Alignof/SeccampConnect2026/README.md

# SeccampConnect2026
  Security Camp Connect 2026
