Alignof/SeccampConnect2026/(list of files, drawings)

Other design files:
Fritzing/keyboard.fzz
