Alignof/SeccampConnect2026/Kicad/board.kicad_pcb

## KiCad design Kicad/board.kicad_pcb (2026-03-22)

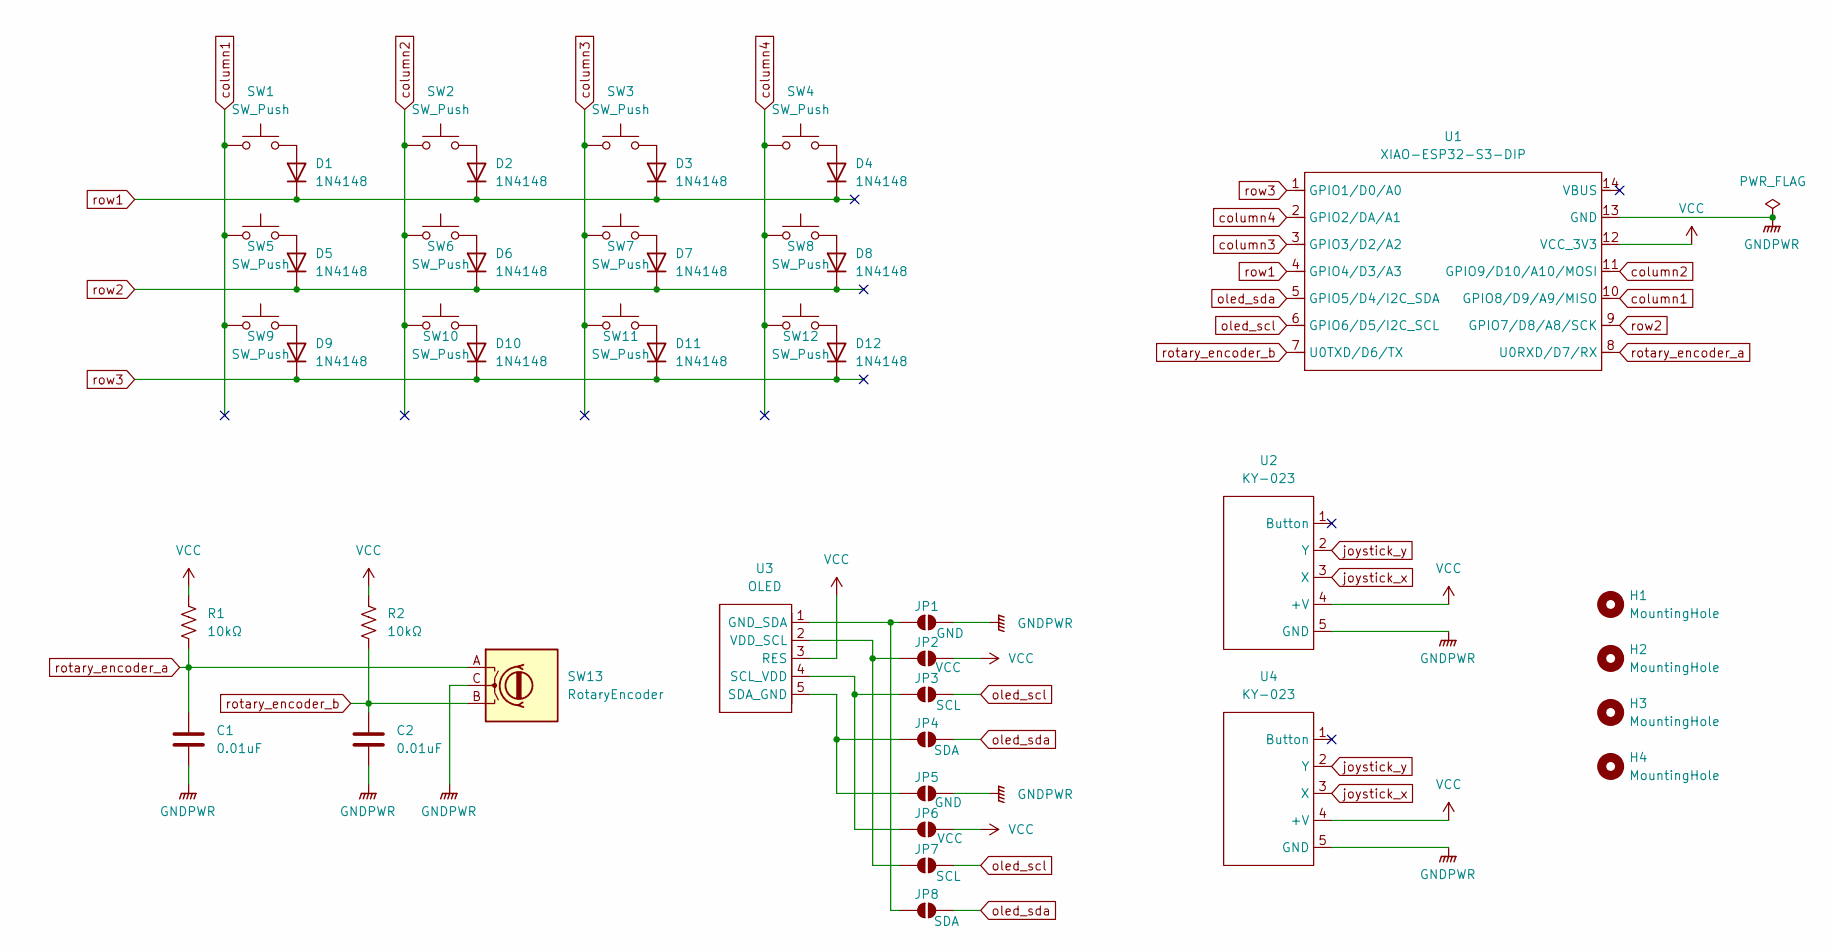
[picture p1: schematic board.kicad_sch]

Parts:
C1, C2: 0.01uF; C_0805_2012_HandSolder_reversible
D1, D2, D3, D4, D5, D6, D7, D8, D9, D10, D11, D12: 1N4148; Diode_THT_reversible
H1, H2, H3, H4: MountingHole; MountingHole_2.7mm
JP1, JP5: GND; SolderJumper-2_P1.3mm_Open_TrianglePad1.0x1.5mm
JP2, JP6: VCC; SolderJumper-2_P1.3mm_Open_TrianglePad1.0x1.5mm
JP3, JP7: SCL; SolderJumper-2_P1.3mm_Open_TrianglePad1.0x1.5mm
JP4, JP8: SDA; SolderJumper-2_P1.3mm_Open_TrianglePad1.0x1.5mm
R1, R2: 10kΩ; R_L6.3mm_D2.5mm_P10.16mm_Horizontal_reversible
SW1, SW2, SW3, SW4, SW5, SW6, SW7, SW8, SW9, SW10, SW11, SW12: SW_Push; Kailh_socket_PG1350_optional_reversible
SW13: RotaryEncoder; RotaryEncoder_Alps_EC12E_Vertical_H20mm
U1: XIAO-ESP32-S3-DIP; XIAO-ESP32S3_reversible
U2, U4: KY-023
U3: OLED; PinSocket_1x05_P2.54mm_Vertical

Connections:
GNDPWR: C1.2, C2.2, JP1.2 (B), JP5.2 (B), SW13.C, U1.13 (GND), U2.5 (GND), U4.5 (GND)
unnamed: D1.2 (A), SW1.2
unnamed: D2.2 (A), SW2.2
unnamed: D3.2 (A), SW3.2
unnamed: D4.2 (A), SW4.2
unnamed: D5.2 (A), SW5.2
unnamed: D6.2 (A), SW6.2
unnamed: D7.2 (A), SW7.2
unnamed: D8.2 (A), SW8.2
unnamed: D9.2 (A), SW9.2
unnamed: D10.2 (A), SW10.2
unnamed: D11.2 (A), SW11.2
unnamed: D12.2 (A), SW12.2
unnamed: JP1.1 (A), JP8.1 (A), U3.1 (GND_SDA)
unnamed: JP2.1 (A), JP7.1 (A), U3.2 (VDD_SCL)
unnamed: JP3.1 (A), JP6.1 (A), U3.4 (SCL_VDD)
unnamed: JP4.1 (A), JP5.1 (A), U3.5 (SDA_GND)
unnamed: U2.2 (Y), U4.2 (Y)
unnamed: U2.3 (X), U4.3 (X)
VCC: JP2.2 (B), JP6.2 (B), R1.1, R2.1, U1.12 (VCC_3V3), U2.4 (+V), U3.3 (RES), U4.4 (+V)
column1: SW1.1, SW5.1, SW9.1, U1.10 (GPIO8/D9/A9/MISO)
column2: SW2.1, SW6.1, SW10.1, U1.11 (GPIO9/D10/A10/MOSI)
column3: SW3.1, SW7.1, SW11.1, U1.3 (GPIO3/D2/A2)
column4: SW4.1, SW8.1, SW12.1, U1.2 (GPIO2/DA/A1)
oled_scl: JP3.2 (B), JP7.2 (B), U1.6 (GPIO6/D5/I2C_SCL)
oled_sda: JP4.2 (B), JP8.2 (B), U1.5 (GPIO5/D4/I2C_SDA)
rotary_encoder_a: C1.1, R1.2, SW13.A, U1.8 (U0RXD/D7/RX)
rotary_encoder_b: C2.1, R2.2, SW13.B, U1.7 (U0TXD/D6/TX)
row1: D1.1 (K), D2.1 (K), D3.1 (K), D4.1 (K), U1.4 (GPIO4/D3/A3)
row2: D5.1 (K), D6.1 (K), D7.1 (K), D8.1 (K), U1.9 (GPIO7/D8/A8/SCK)
row3: D9.1 (K), D10.1 (K), D11.1 (K), D12.1 (K), U1.1 (GPIO1/D0/A0)

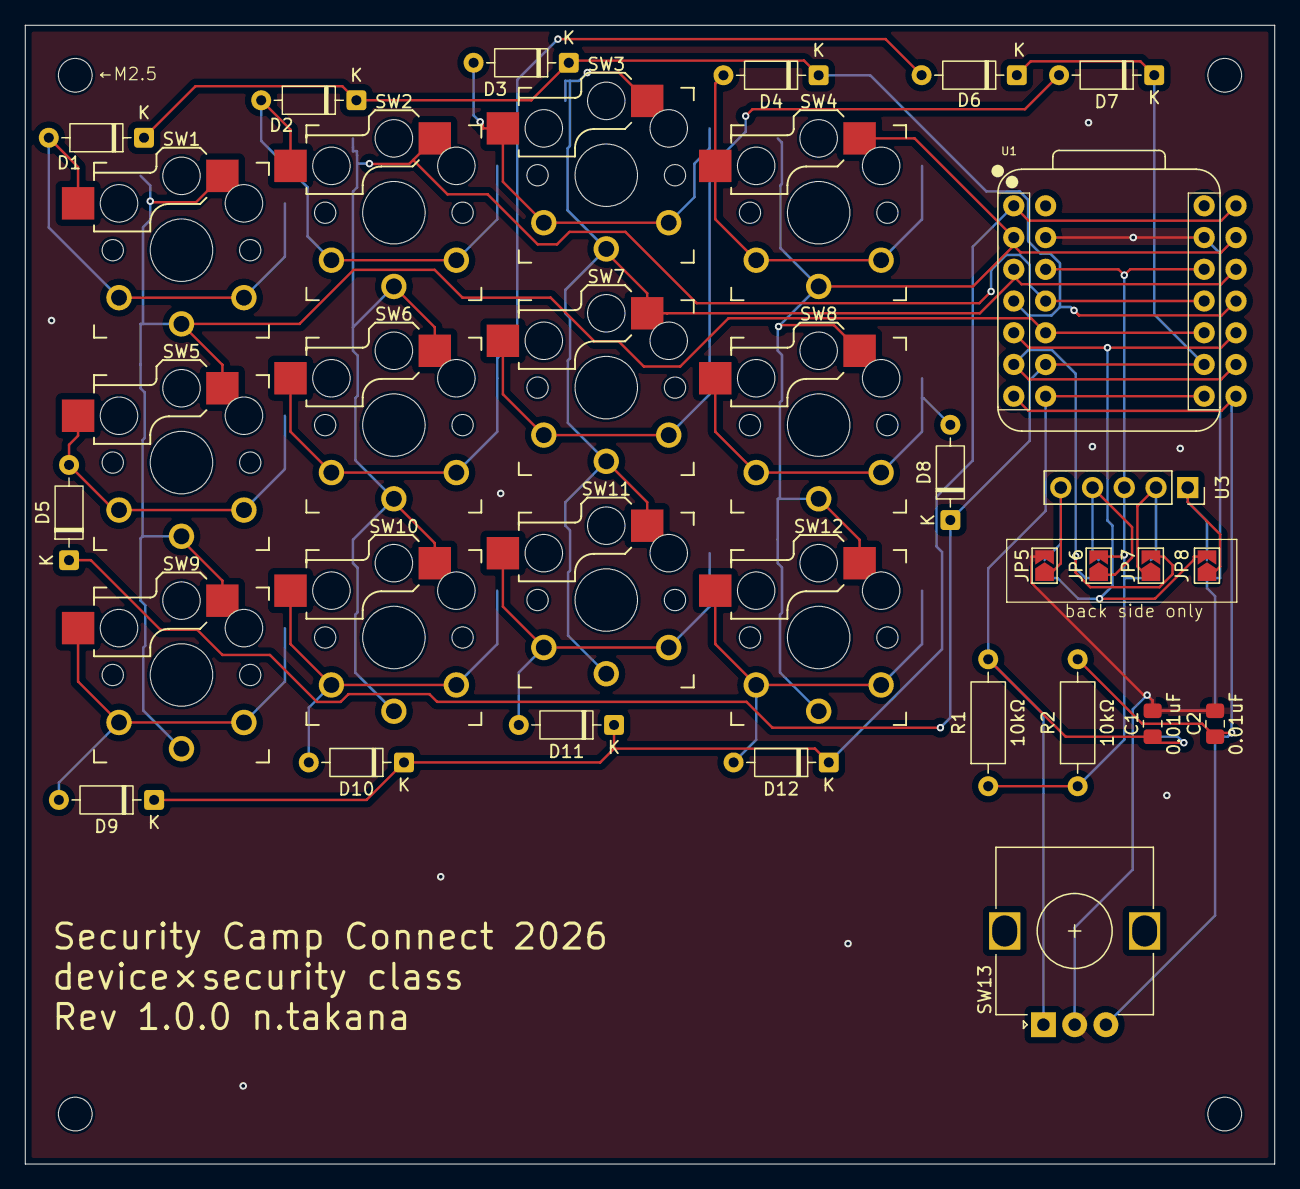
[picture p2: board board.kicad_pcb from above]

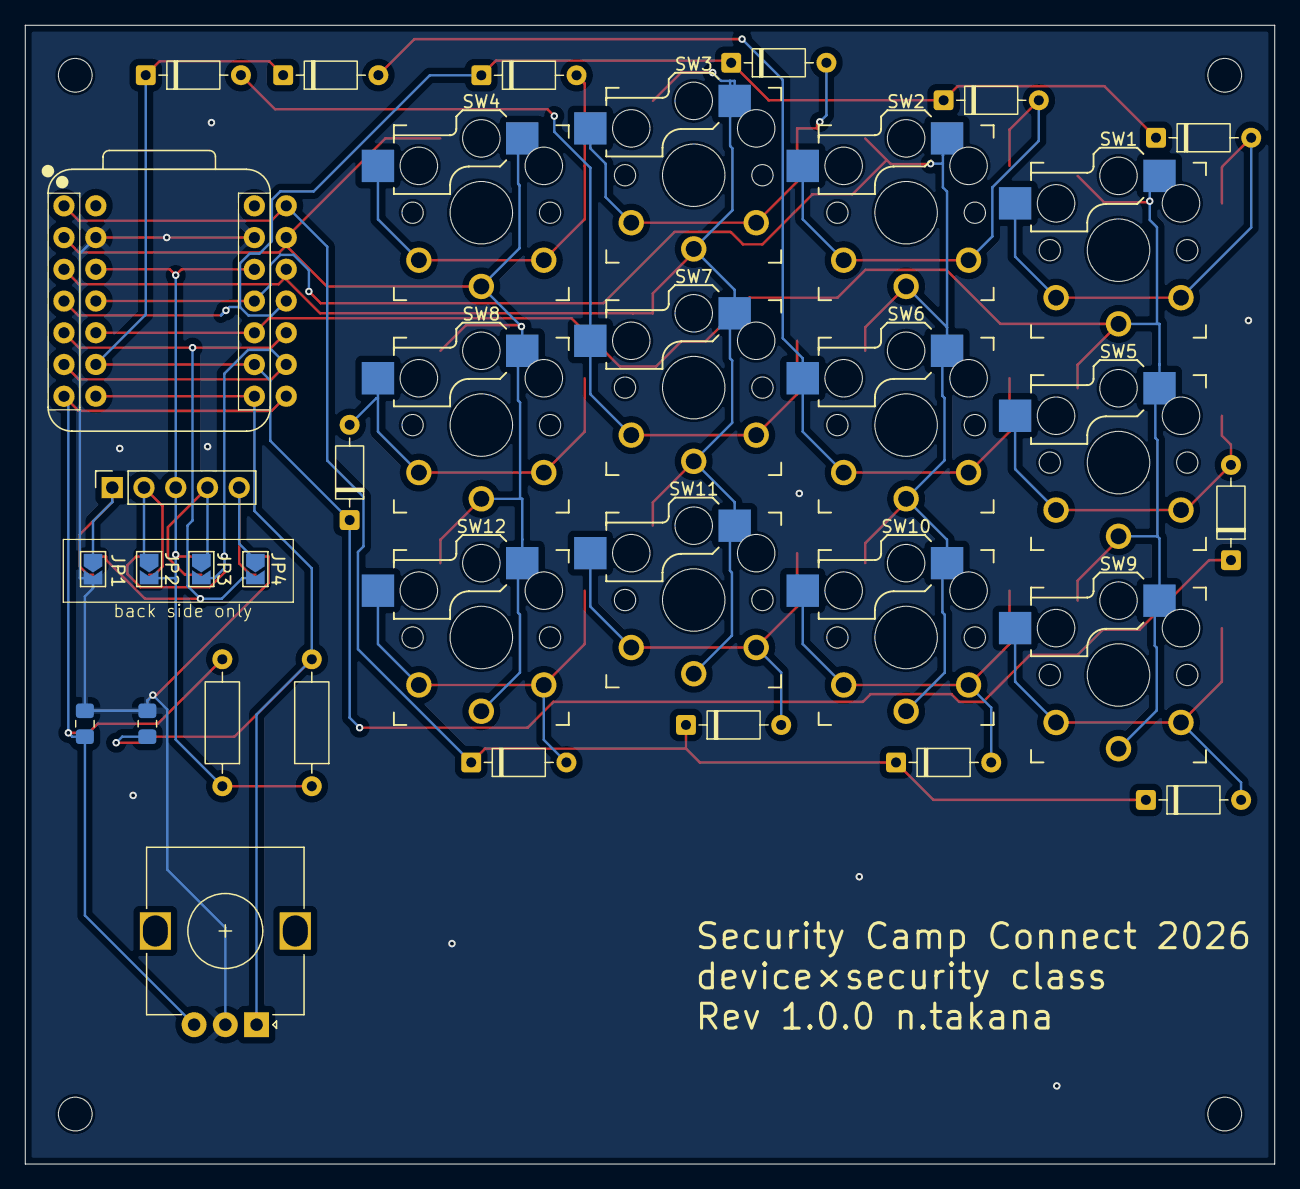
[picture p3: board board.kicad_pcb from below]

Board: 2 copper layers, 100.0 x 91.1 mm, 43 parts (4 on the bottom side), 29 nets.
