Alignof/SeccampConnect2026/src/main.rs

//! Security Camp Connect 2026
//!
//! [https://www.ipa.go.jp/jinzai/security-camp/2025/connect/device.html](https://www.ipa.go.jp/jinzai/security-camp/2025/connect/device.html)
//!
//! 3x4 prototyping keyboards designed for hands-on practice.
//!
//! # Feature
//! - ESP32S3
//! - Vial support
//! - Low profile with 17 mm pitch
//! - Integrated rotary encoder and 0.91-inch OLED

#![no_std]
#![no_main]

mod keymap;
#[macro_use]
mod macros;
mod oled;
mod vial;

use core::ptr::addr_of_mut;

use bt_hci::controller::ExternalController;
use embassy_executor::Spawner;
use esp_hal::clock::CpuClock;
use esp_hal::gpio::{Input, InputConfig, Level, Output, OutputConfig, Pull};
use esp_hal::otg_fs::Usb;
use esp_hal::otg_fs::asynch::{Config, Driver};
use esp_hal::rng::TrngSource;
use esp_hal::timer::timg::TimerGroup;
use esp_radio::Controller;
use esp_radio::ble::controller::BleConnector;
use esp_storage::FlashStorage;
use rmk::ble::build_ble_stack;
use rmk::channel::EVENT_CHANNEL;
use rmk::config::{
    BehaviorConfig, DeviceConfig, PositionalConfig, RmkConfig, StorageConfig, VialConfig,
};
use rmk::debounce::default_debouncer::DefaultDebouncer;
use rmk::futures::future::join3;
use rmk::input_device::Runnable;
use rmk::input_device::rotary_encoder::DefaultPhase;
use rmk::input_device::rotary_encoder::RotaryEncoder;
use rmk::keyboard::Keyboard;
use rmk::matrix::Matrix;
use rmk::storage::async_flash_wrapper;
use rmk::{HostResources, initialize_encoder_keymap_and_storage, run_devices, run_rmk};
use ssd1306::prelude::DisplayRotation;
use static_cell::StaticCell;
use {esp_alloc as _, esp_backtrace as _};

use crate::keymap::{COL, ROW};
use crate::vial::{VIAL_KEYBOARD_DEF, VIAL_KEYBOARD_ID};

::esp_bootloader_esp_idf::esp_app_desc!();

/// Main function.
///
/// Initialize devices and spawn rmk tasks.
#[allow(clippy::used_underscore_binding)]
#[esp_rtos::main]
async fn main(spawner: Spawner) {
    // Singleton for ble controller.
    static RADIO: StaticCell<Controller<'static>> = StaticCell::new();
    // Endpoint buffer for USB transfer.
    static mut EP_MEMORY: [u8; 1024] = [0; 1024];

    // Initialize the peripherals and bluetooth controller
    esp_println::logger::init_logger_from_env();
    let peripherals = esp_hal::init(esp_hal::Config::default().with_cpu_clock(CpuClock::max()));
    esp_alloc::heap_allocator!(size: 72 * 1024);
    let timg0 = TimerGroup::new(peripherals.TIMG0);
    #[cfg(target_arch = "riscv32")]
    let software_interrupt = SoftwareInterruptControl::new(peripherals.SW_INTERRUPT);
    esp_rtos::start(
        timg0.timer0,
        #[cfg(target_arch = "riscv32")]
        software_interrupt.software_interrupt0,
    );
    let _trng_source = TrngSource::new(peripherals.RNG, peripherals.ADC1);
    let mut rng = esp_hal::rng::Trng::try_new().unwrap();
    let radio = RADIO.init(esp_radio::init().unwrap());
    let bluetooth = peripherals.BT;
    let connector = BleConnector::new(radio, bluetooth, esp_radio::ble::Config::default()).unwrap();
    let controller: ExternalController<_, 20> = ExternalController::new(connector);
    let central_addr = [0x18, 0xe2, 0x21, 0x80, 0xc0, 0xc7];
    let mut host_resources = HostResources::new();
    let stack = build_ble_stack(controller, central_addr, &mut rng, &mut host_resources).await;

    // Initialize USB
    let usb = Usb::new(peripherals.USB0, peripherals.GPIO20, peripherals.GPIO19);
    // Create the driver, from the HAL.
    let config = Config::default();
    let usb_driver = Driver::new(usb, unsafe { &mut *addr_of_mut!(EP_MEMORY) }, config);

    // Initialize the flash
    let flash = FlashStorage::new(peripherals.FLASH);
    let flash = async_flash_wrapper(flash);

    // Spawn oled task
    let display = oled::init_oled(
        peripherals.I2C0,
        peripherals.GPIO5,
        peripherals.GPIO6,
        DisplayRotation::Rotate0,
    )
    .await;
    if let Some(display) = display {
        spawner.spawn(oled::oled_task(display)).unwrap();
    }

    // Initialize the IO pins
    let (row_pins, col_pins) = config_matrix_pins_esp!(peripherals: peripherals, input: [GPIO4, GPIO7, GPIO1], output: [GPIO8, GPIO9, GPIO3, GPIO2]);

    // RMK config
    let vial_config = VialConfig::new(VIAL_KEYBOARD_ID, VIAL_KEYBOARD_DEF, &[(0, 0), (1, 1)]);
    let storage_config = StorageConfig {
        start_addr: 0x3f_0000,
        num_sectors: 16,
        ..Default::default()
    };
    let device_config = DeviceConfig {
        manufacturer: "RMK",
        product_name: "my Keyboard",
        ..Default::default()
    };
    let rmk_config = RmkConfig {
        vial_config,
        storage_config,
        device_config,
        ..Default::default()
    };

    // Initialze keyboard stuffs
    // Initialize the storage and keymap
    let mut default_keymap = keymap::get_default_keymap();
    let mut behavior_config = BehaviorConfig::default();
    let mut encoder_map = keymap::get_default_encoder_map();
    let mut per_key_config = PositionalConfig::default();
    let (keymap, mut storage) = initialize_encoder_keymap_and_storage(
        &mut default_keymap,
        &mut encoder_map,
        flash,
        &storage_config,
        &mut behavior_config,
        &mut per_key_config,
    )
    .await;

    // Initialize the matrix and keyboard
    let debouncer = DefaultDebouncer::new();
    let mut matrix = Matrix::<_, _, _, ROW, COL, true>::new(row_pins, col_pins, debouncer);
    let mut keyboard = Keyboard::new(&keymap); // Initialize the light controller

    // Initialize rotary encoder
    let pin_a = Input::new(peripherals.GPIO43, InputConfig::default());
    let pin_b = Input::new(peripherals.GPIO44, InputConfig::default());
    let mut encoder = RotaryEncoder::with_phase(pin_a, pin_b, DefaultPhase, 0);

    join3(
        run_devices! (
            (matrix, encoder) => EVENT_CHANNEL,
        ),
        keyboard.run(), // Keyboard is special
        run_rmk(&keymap, usb_driver, &stack, &mut storage, rmk_config),
    )
    .await;
}
