Alignof/SeccampConnect2026/(commit log)

2025-10-08 [fix] add esp-bootloader-esp-idf and update some crates version
    [main.rs]
2025-12-20 [add] support for rotary encoder
2025-12-20 [add] add Fritzing data
    [keyboard.fzz]
2025-12-26 [add] add kicad data
    [board.kicad_pcb, board.kicad_sch]
2026-01-01 [add] add through hole
    [board.kicad_pcb, board.kicad_sch]
2026-01-01 [update] move diodes
    [board.kicad_pcb]
2026-01-01 [update] move key layout
    [board.kicad_pcb]
2026-01-01 [update] routed
    [board.kicad_pcb]
2026-01-02 [add] add sign to silk layer
    [board.kicad_pcb, board.kicad_sch]
2026-03-04 [update] modify pin assign to match pcb specification
2026-03-05 [refactor] apply `cargo clippy --fix`
    [build.rs, main.rs]
2026-03-05 [fix] fix a pin name of esp32s3
    [board.kicad_sch]
2026-03-06 [update] schematic in Fritzing/keyboard.fzz
    [keyboard.fzz]
2026-03-06 [fix] modify docker tag to lower case
2026-03-15 [add] add an oled device and revise pin assign
    [board.kicad_sch]
2026-03-16 [update] update footprint
    [board.kicad_sch]
2026-03-17 [add] add solder jumpers to support reversible pin holes
    [board.kicad_sch]
2026-03-17 [add] add a footprint supports both choc v1 and v2
2026-03-17 [update] update diode footprint
    [board.kicad_sch]
2026-03-17 [update] re-annotate symbols
    [board.kicad_sch]
2026-03-17 [add] add reversible footprints
2026-03-17 [update] clear the ERC
    [board.kicad_sch]
2026-03-17 [add] place parts in pcb editor
    [board.kicad_pcb]
2026-03-17 [add] add XIAO-ESP32S3_reversible.kicad_mod
2026-03-17 [update] set 3D model path to Kailh key switch
2026-03-17 [update] update silk and parts placement
    [board.kicad_pcb]
2026-03-17 [!][fix] fix power line connection
    [board.kicad_pcb, board.kicad_sch]
2026-03-22 [fix] re-introduce clippy-reviewdog-filter
2026-03-23 [fix] add the allow macro to autogenerated codes
    [build.rs]
2026-03-23 [refactor] fix cargo clippy warnings
    [build.rs, main.rs]
2026-03-24 [add] add partitions.csv
    [partitions.csv]
2026-03-26 [fix] correct gpio assign
    [main.rs]
2026-03-27 [fix] handle optional OLED display initialization and task spawning
    [main.rs, oled.rs]
2026-03-27 [fix] update init_oled function to return None on initialization failure
    [oled.rs]
